garabullo/garabullo2018/imagenes wiki/step_up_regular.jpg

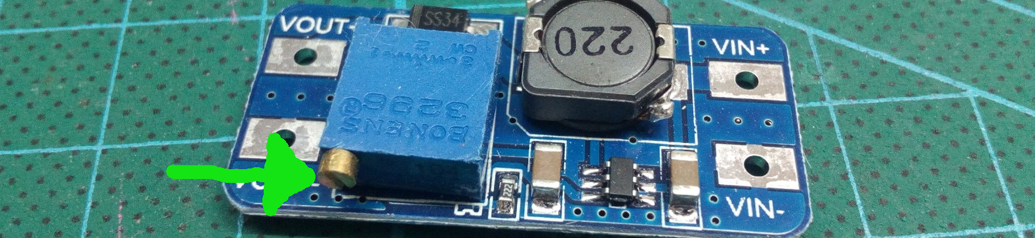
imagenes wiki/step_up_regular.jpg
