garabullo/garabullo2018/imagenes wiki/regular_step_up.jpg

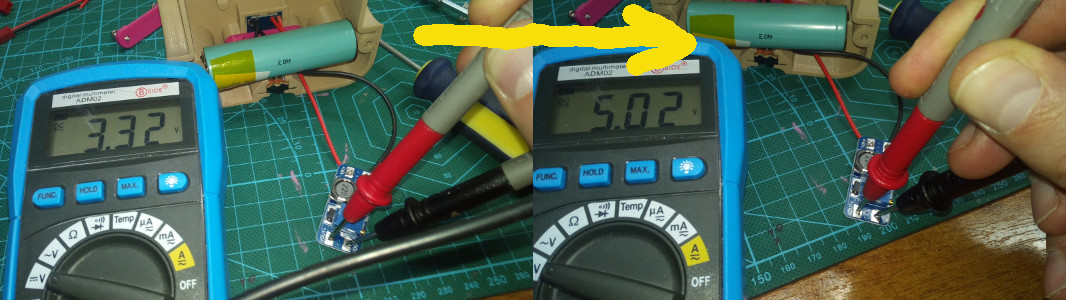
imagenes wiki/regular_step_up.jpg
