garabullo/garabullo2018/README.md

# garabullo2018
Versión 2018 del robot garabullo
Toda la información en https://github.com/garabullo/garabullo2018/wiki/1-Home
