garabullo/garabullo2018/imagenes placa/10k_2.jpg

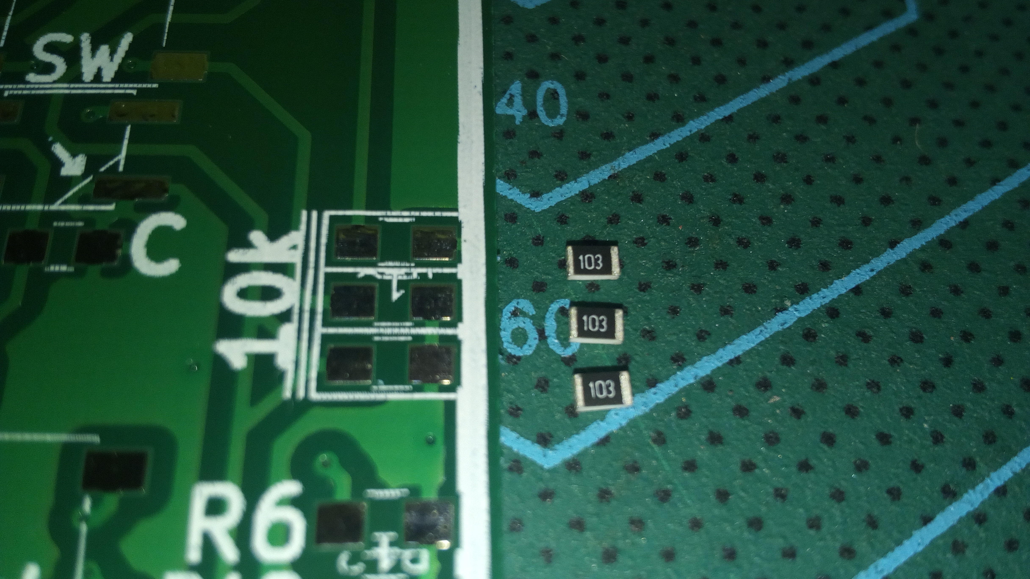
imagenes placa/10k_2.jpg
