garabullo/garabullo2018/imagenes placa/10k_5.jpg

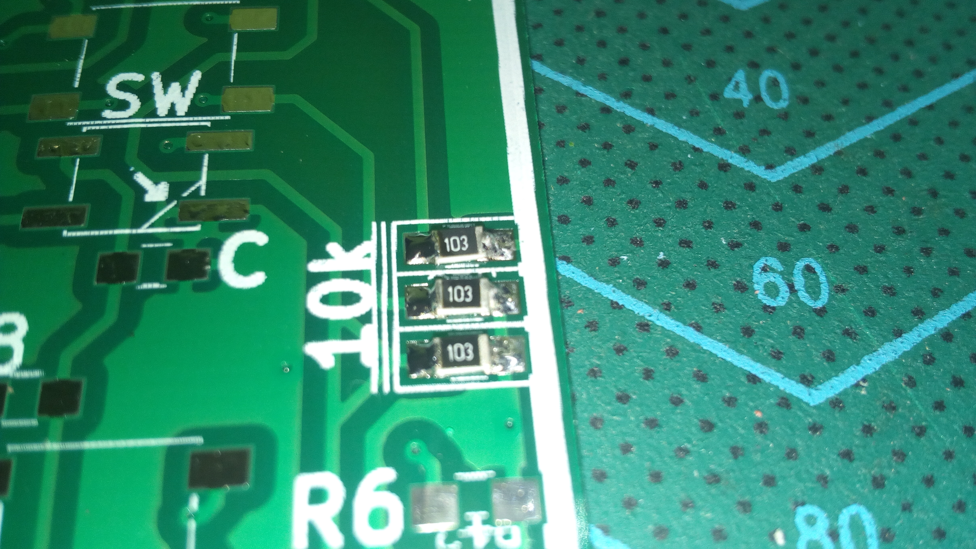
imagenes placa/10k_5.jpg
