garabullo/garabullo2018/imagenes placa/buzzer_2.jpg

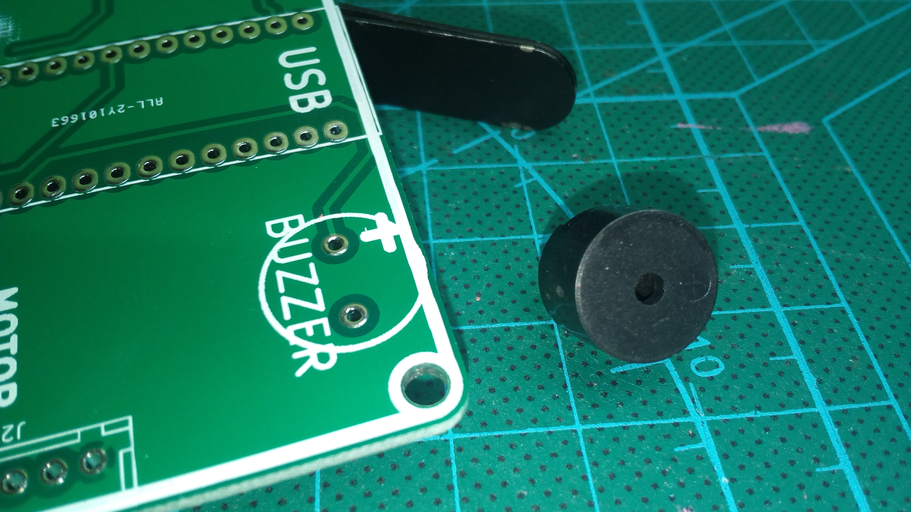
imagenes placa/buzzer_2.jpg
