garabullo/garabullo2018/imagenes placa/buzzer_3.jpg

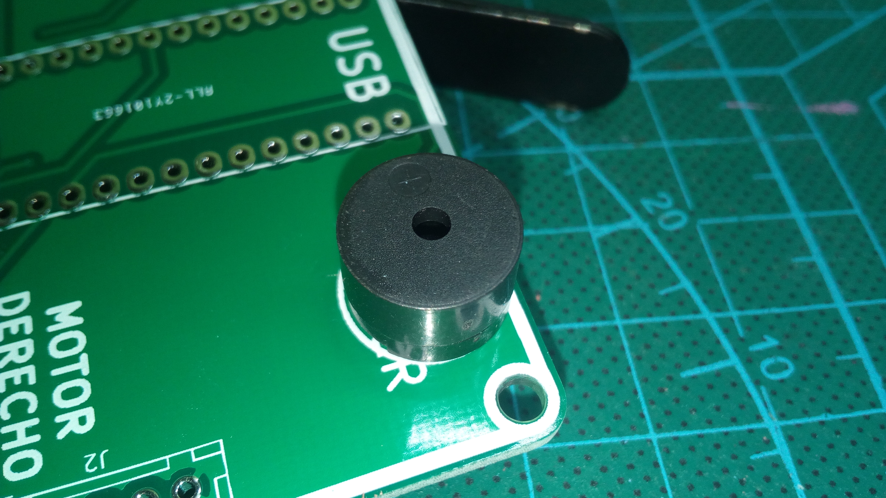
imagenes placa/buzzer_3.jpg
