garabullo/garabullo2018/imagenes placa/buzzer_ 1.jpg

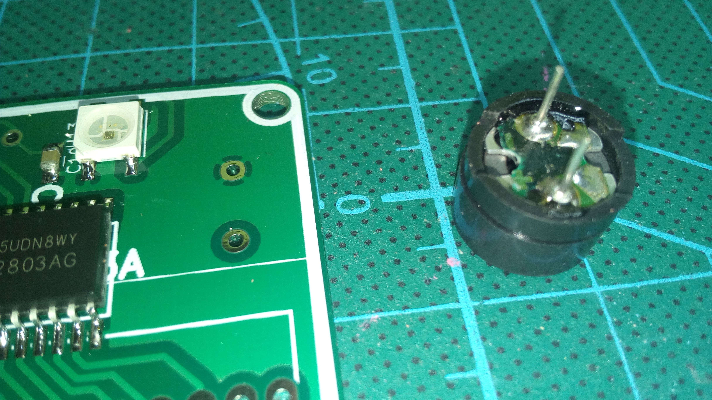
imagenes placa/buzzer_ 1.jpg
