garabullo/garabullo2018/imagenes placa/con_motor1.jpg

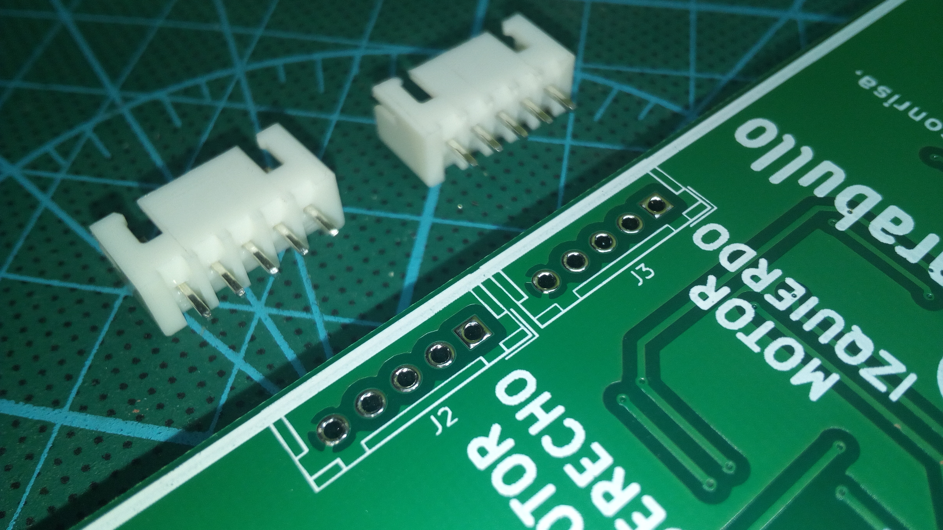
imagenes placa/con_motor1.jpg
