garabullo/garabullo2018/imagenes placa/con_motor2.jpg

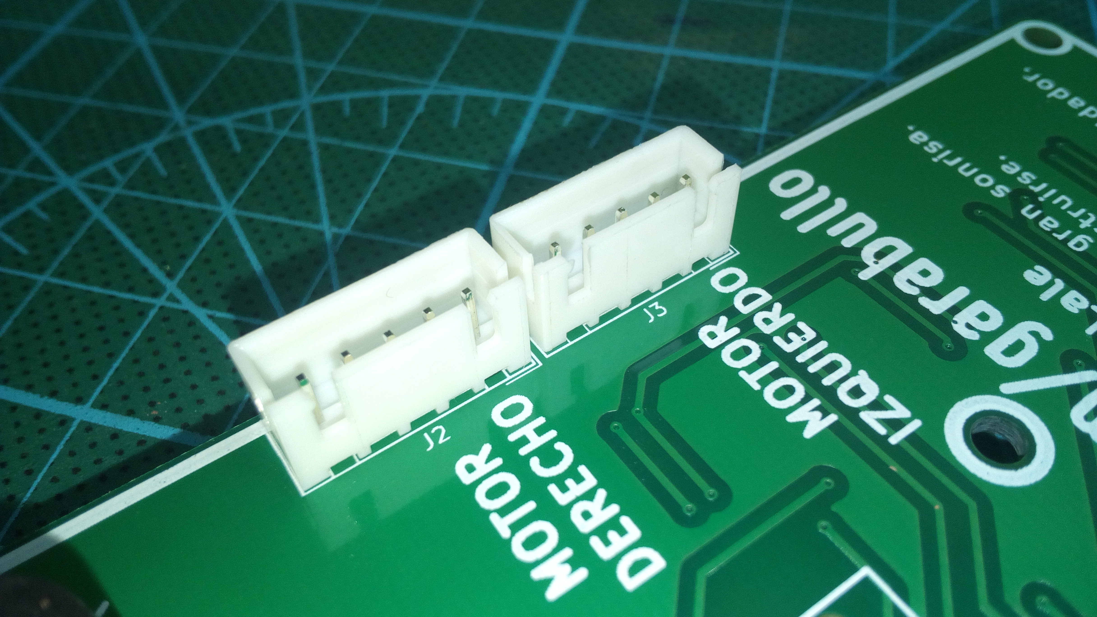
imagenes placa/con_motor2.jpg
