garabullo/garabullo2018/imagenes placa/condensador_1.jpg

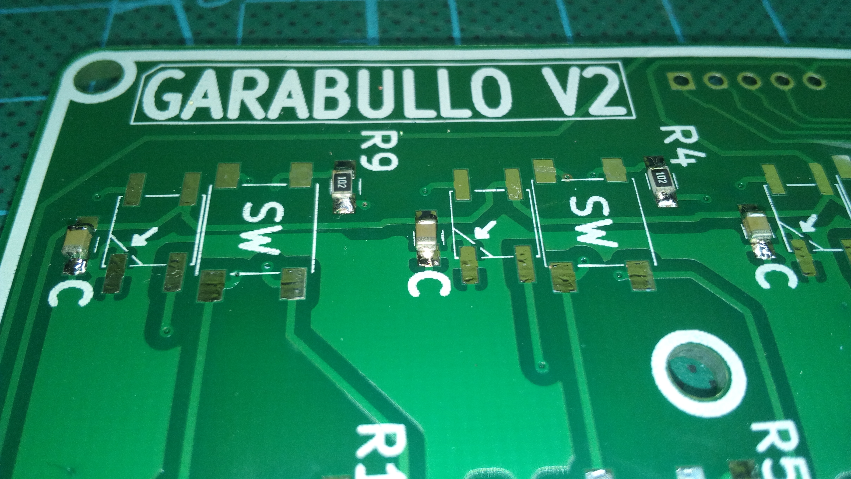
imagenes placa/condensador_1.jpg
