garabullo/garabullo2018/imagenes placa/garabullo.png

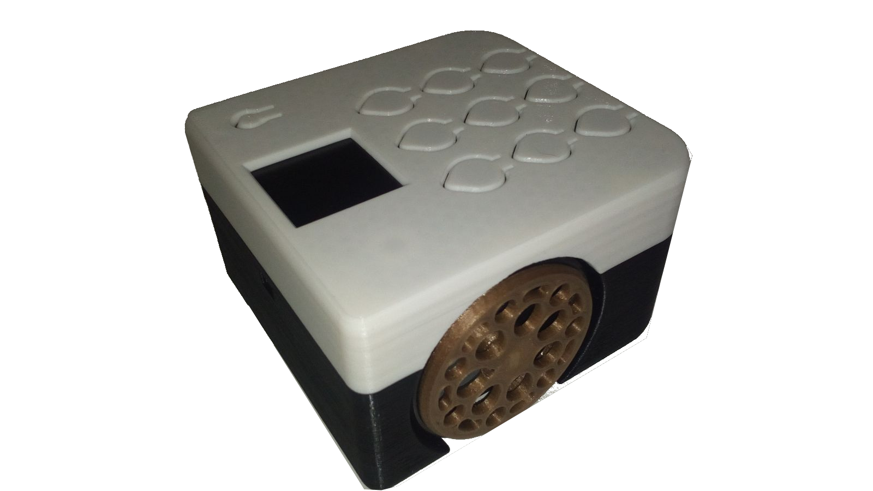
imagenes placa/garabullo.png
