garabullo/garabullo2018/imagenes placa/IMG_20180305_155818.jpg

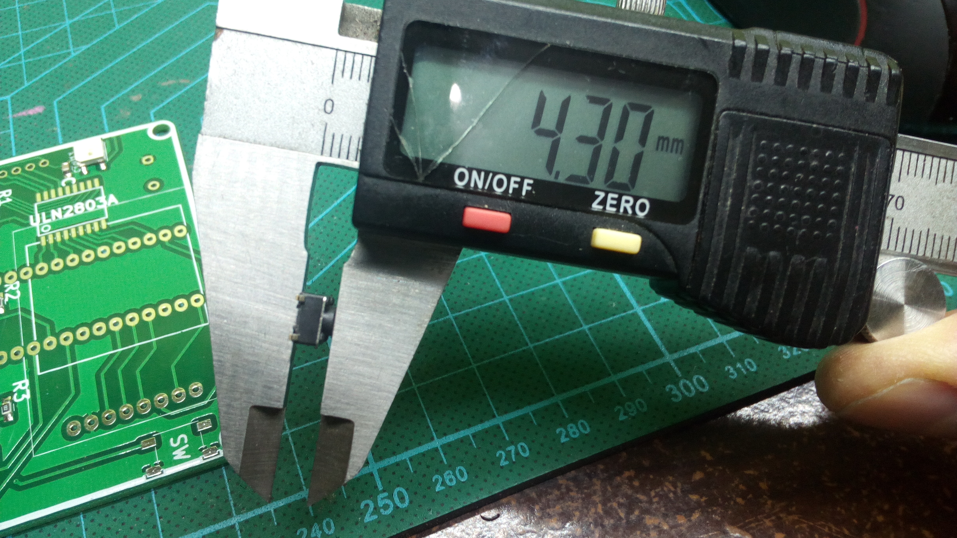
imagenes placa/IMG_20180305_155818.jpg
