garabullo/garabullo2018/imagenes placa/led_1.jpg

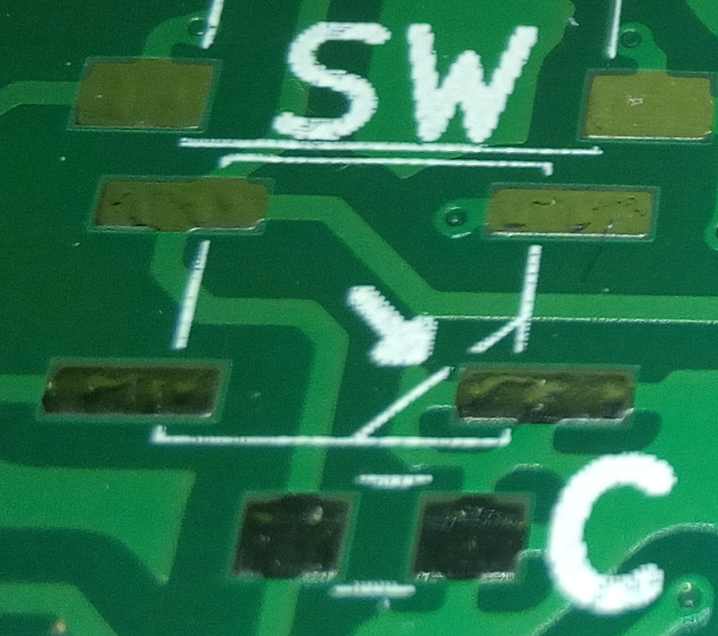
imagenes placa/led_1.jpg
