garabullo/garabullo2018/imagenes placa/led_3.jpg

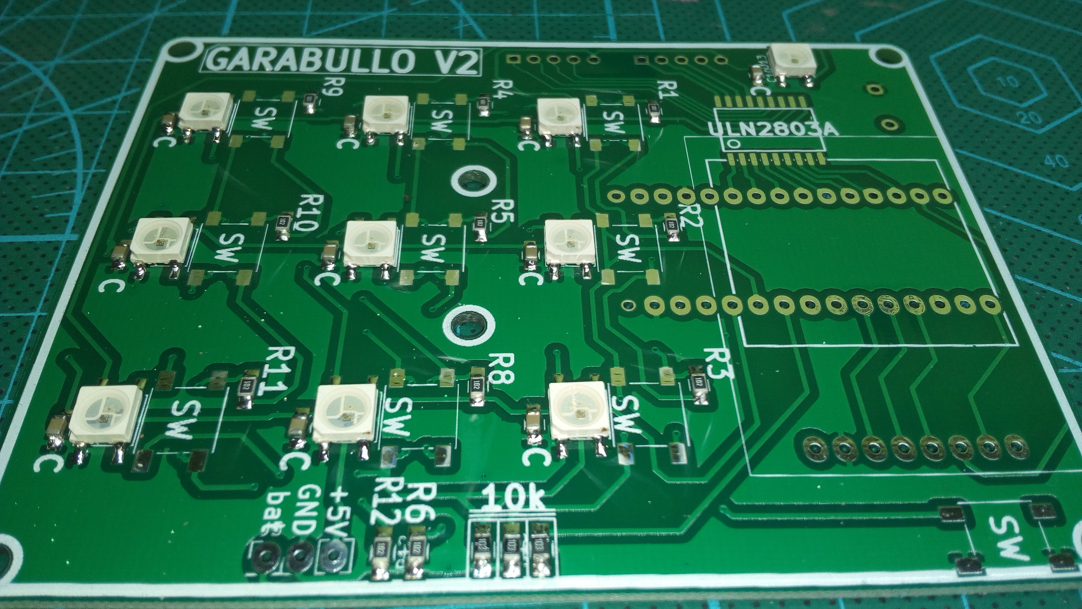
imagenes placa/led_3.jpg
