garabullo/garabullo2018/imagenes placa/magic_tiles.jpg

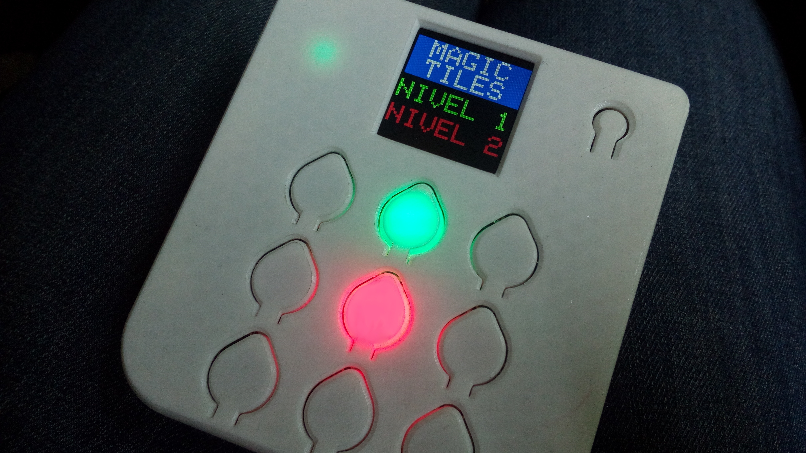
imagenes placa/magic_tiles.jpg
