garabullo/garabullo2018/imagenes placa/nivel1.jpg

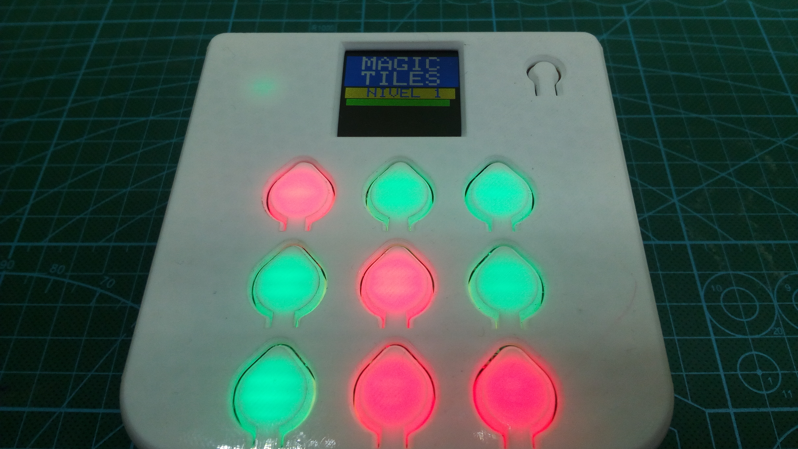
imagenes placa/nivel1.jpg
