garabullo/garabullo2018/imagenes placa/nivel2.jpg

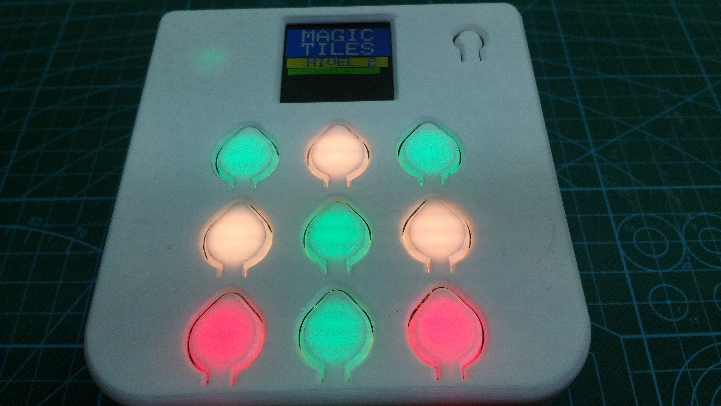
imagenes placa/nivel2.jpg
