garabullo/garabullo2018/imagenes placa/pantalla_driver.jpg

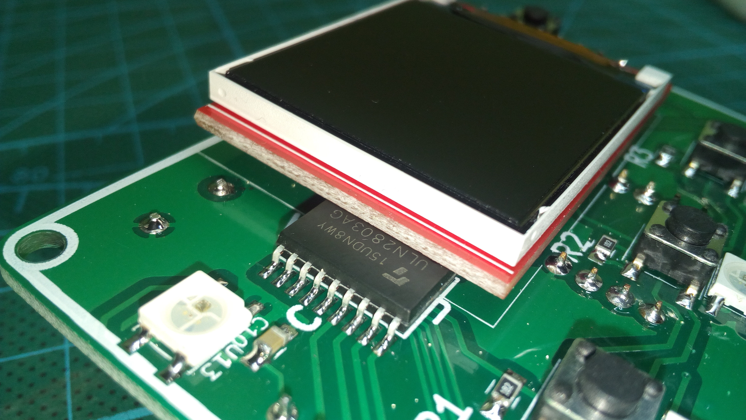
imagenes placa/pantalla_driver.jpg
