garabullo/garabullo2018/imagenes placa/pantalla_magic_tiles.jpg

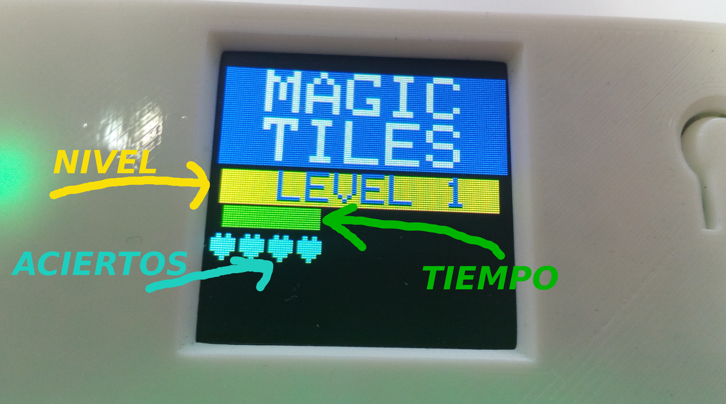
imagenes placa/pantalla_magic_tiles.jpg
