garabullo/garabullo2018/imagenes placa/pines_arduino_2.jpg

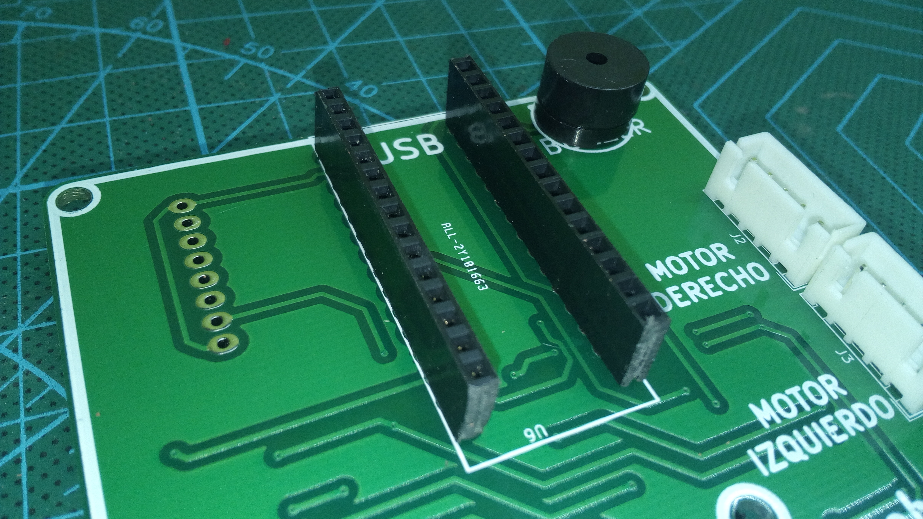
imagenes placa/pines_arduino_2.jpg
