garabullo/garabullo2018/imagenes wiki/baterias1.jpg

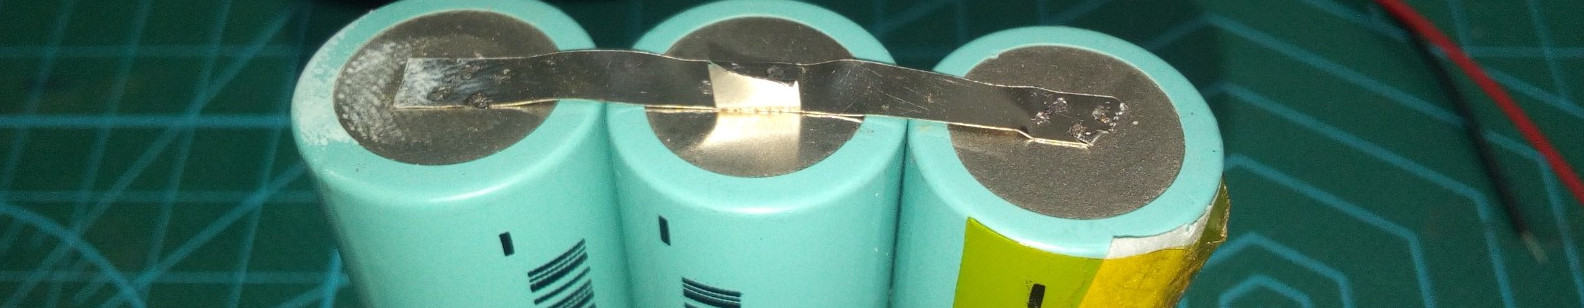
imagenes wiki/baterias1.jpg
