garabullo/garabullo2018/imagenes wiki/baterias2.jpg

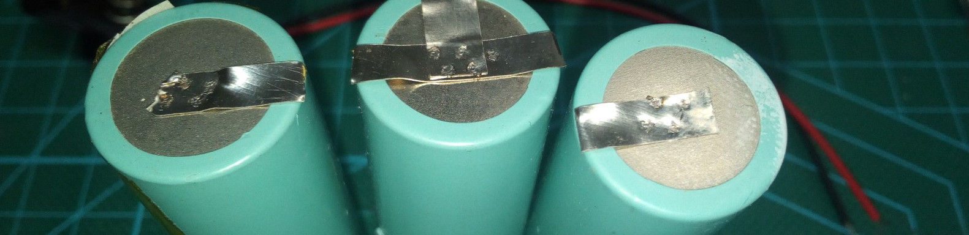
imagenes wiki/baterias2.jpg
