garabullo/garabullo2018/imagenes wiki/cable_servo.jpg

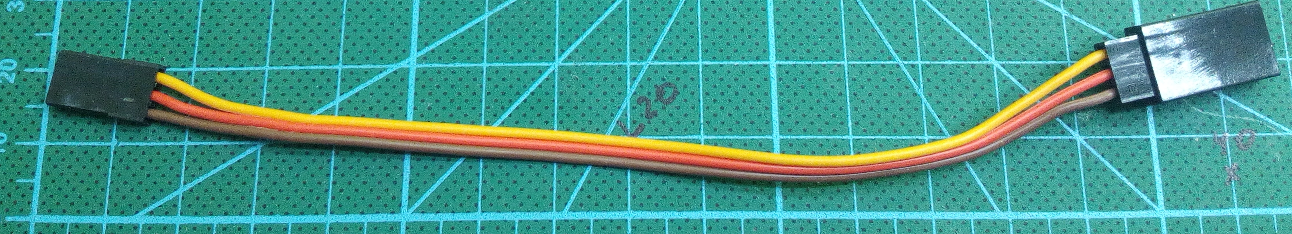
imagenes wiki/cable_servo.jpg
