garabullo/garabullo2018/imagenes wiki/cable_servo_cortado.jpg

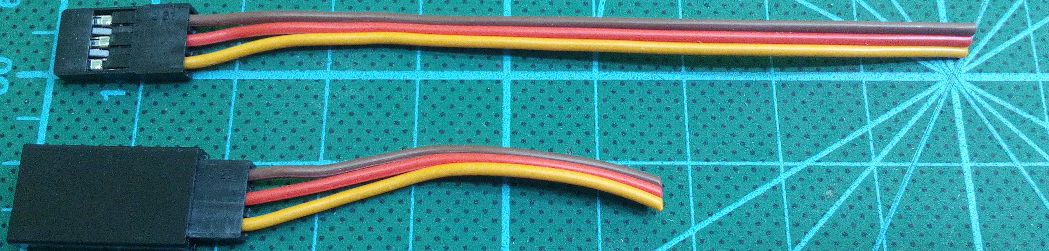
imagenes wiki/cable_servo_cortado.jpg
