garabullo/garabullo2018/imagenes wiki/cables.jpg

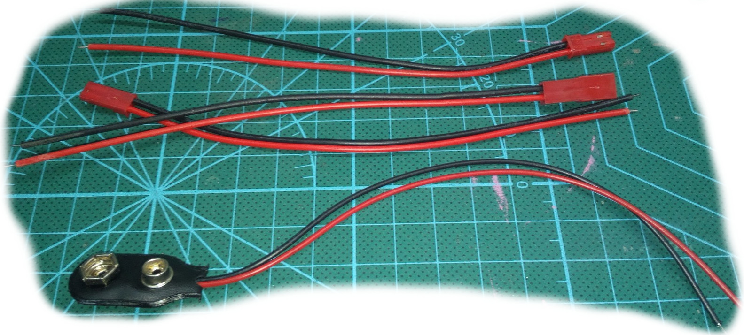
imagenes wiki/cables.jpg
