garabullo/garabullo2018/imagenes wiki/cables_varios.jpg

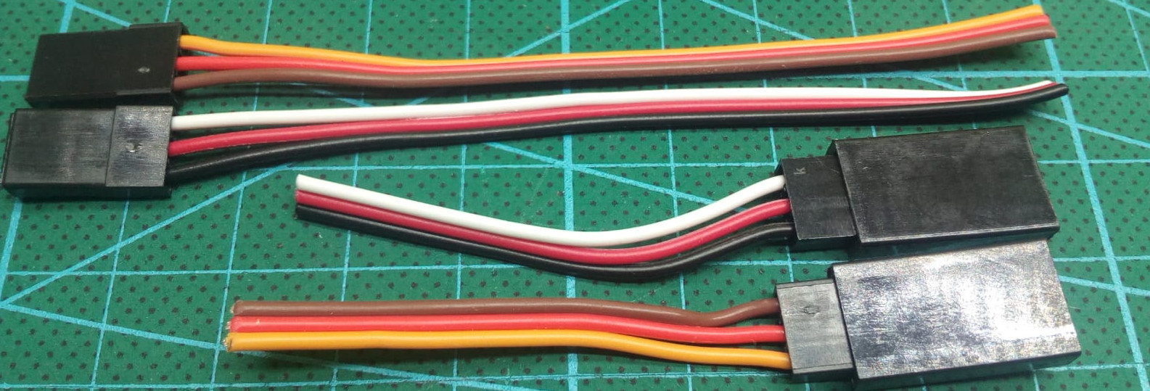
imagenes wiki/cables_varios.jpg
