garabullo/garabullo2018/imagenes wiki/cargadores.jpg

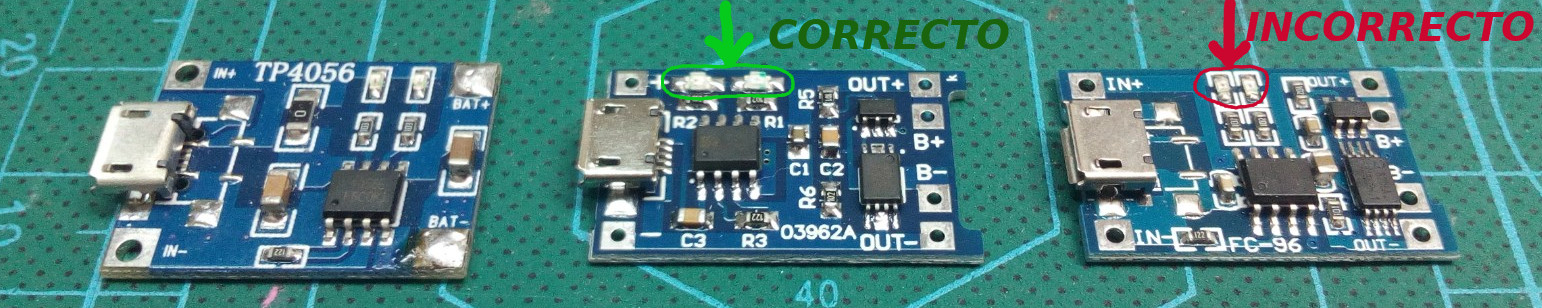
imagenes wiki/cargadores.jpg
