garabullo/garabullo2018/imagenes wiki/conexion_salida stepup.jpg

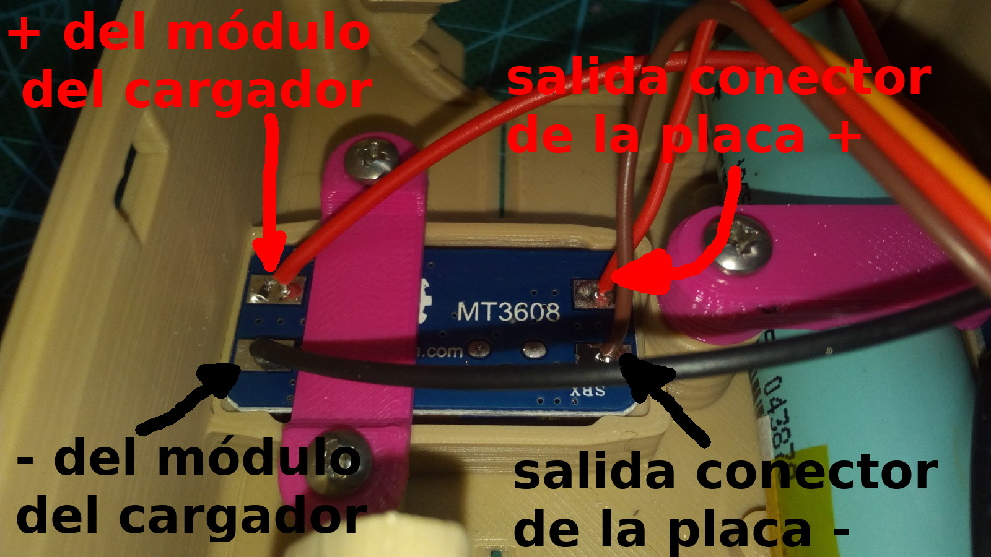
imagenes wiki/conexion_salida stepup.jpg
