garabullo/garabullo2018/imagenes wiki/garabullo.jpeg

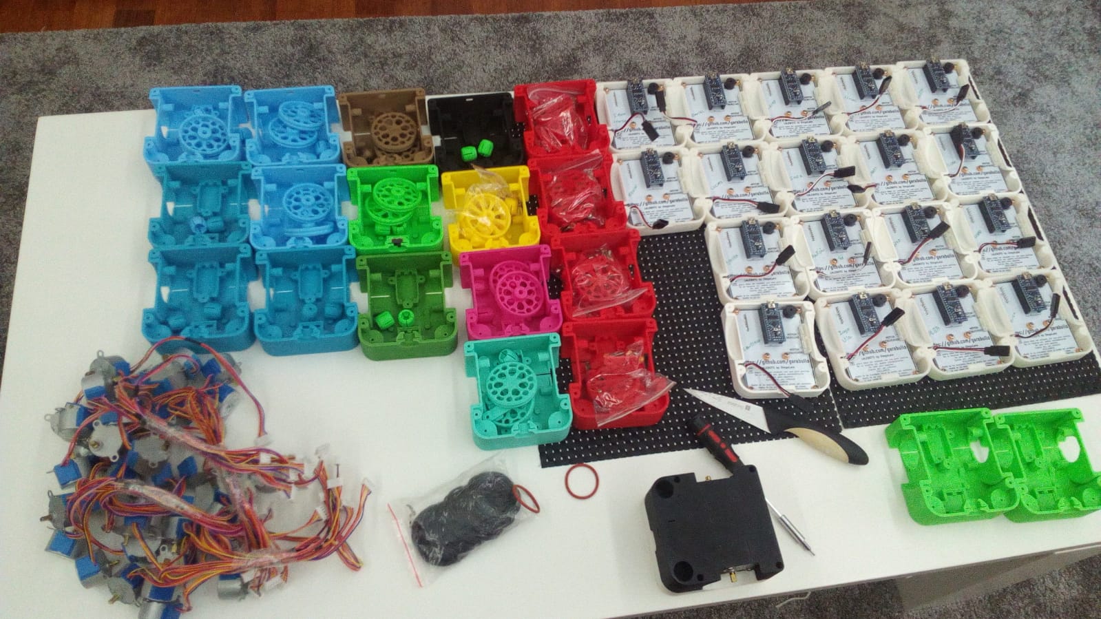
imagenes wiki/garabullo.jpeg
