garabullo/garabullo2018/imagenes wiki/interruptor_colocado.jpg

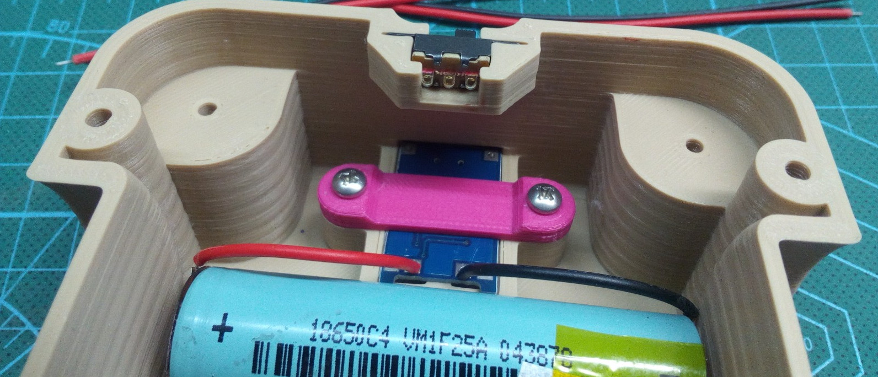
imagenes wiki/interruptor_colocado.jpg
