garabullo/garabullo2018/imagenes wiki/interruptor_soldado.jpg

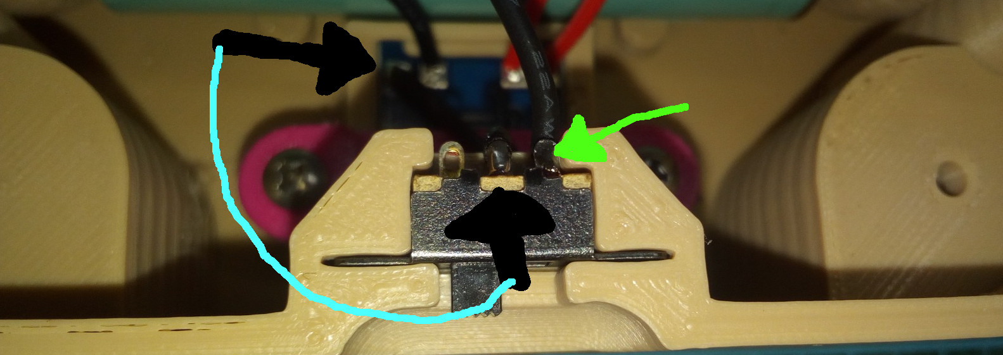
imagenes wiki/interruptor_soldado.jpg
