garabullo/garabullo2018/imagenes wiki/lamina_bateria.jpg

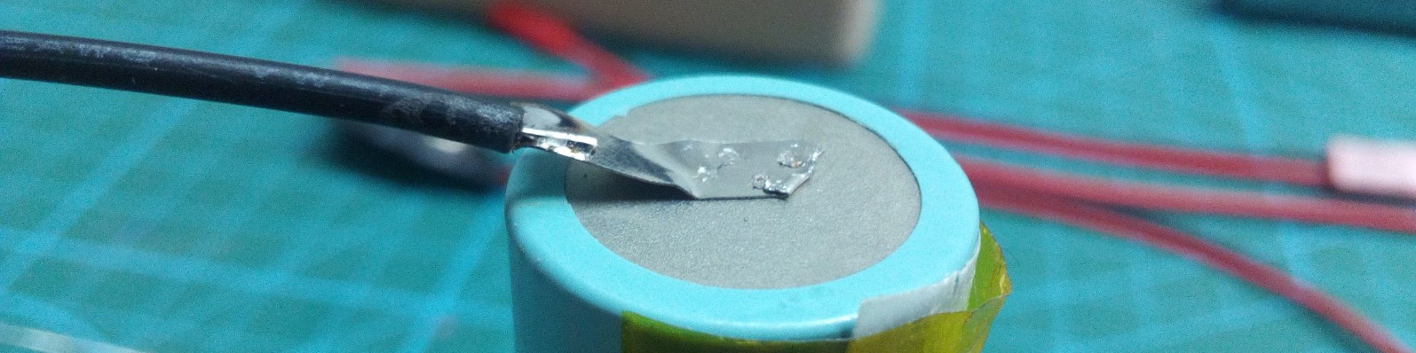
imagenes wiki/lamina_bateria.jpg
