garabullo/garabullo2018/imagenes wiki/paso1.jpg

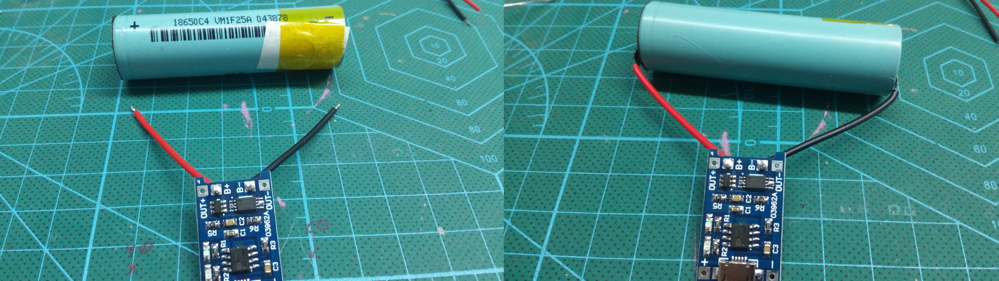
imagenes wiki/paso1.jpg
