garabullo/garabullo2018/imagenes wiki/sonda_bateria.jpg

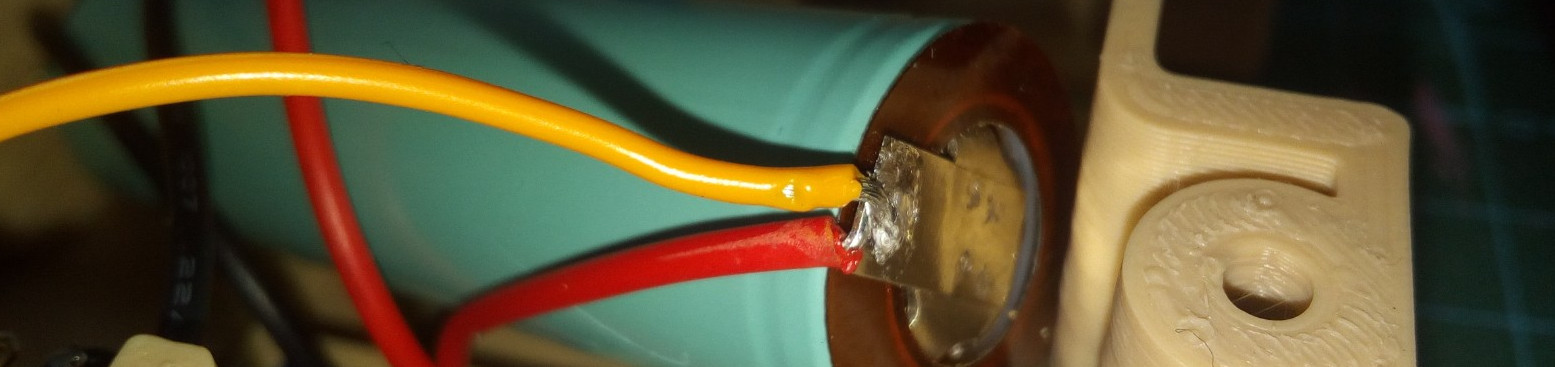
imagenes wiki/sonda_bateria.jpg
