garabullo/garabullo2018/imagenes wiki/stepup.jpg

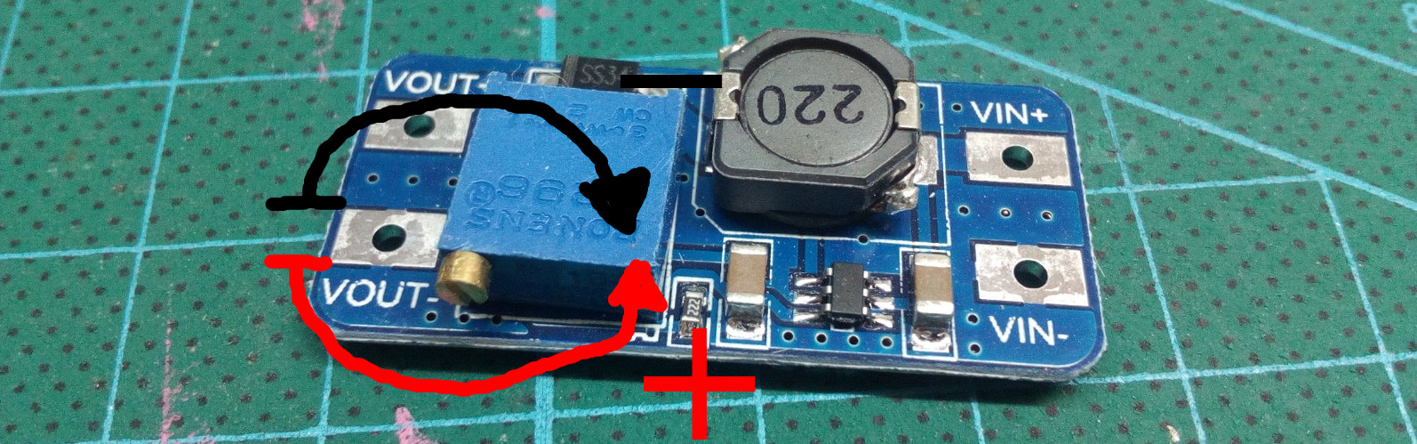
imagenes wiki/stepup.jpg
