garabullo/garabullo2018/Piezas imprimibles/src/rueda_d.fcstd

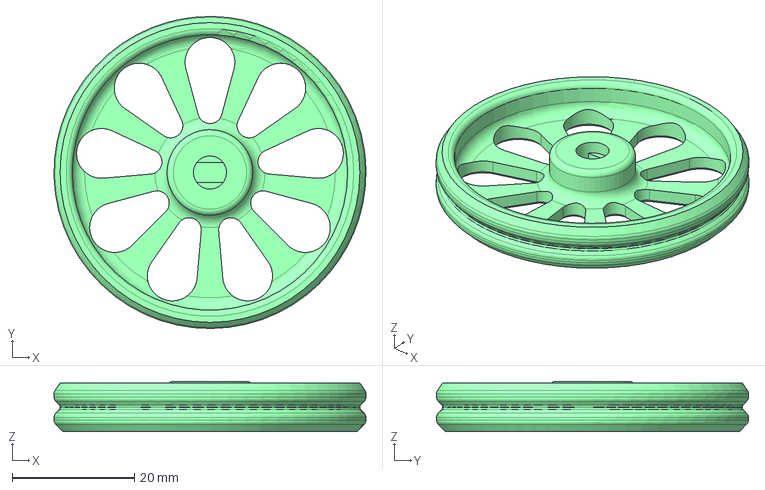
[picture p36: CAD file, 2018-03-11]
Piezas imprimibles/src/rueda_d.fcstd
51.0 x 51.0 x 8.25 mm
