garabullo/garabullo2018/Piezas imprimibles/stl/garabullo_consola.stl

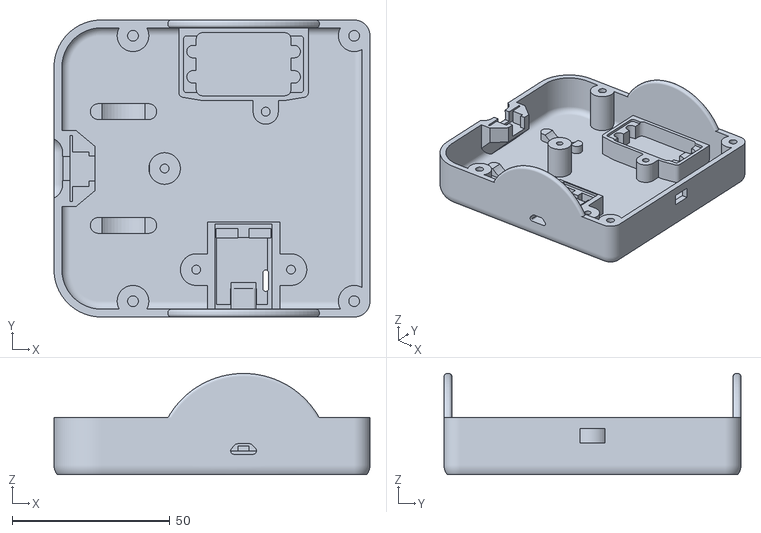
[picture p37: CAD file, 2018-10-27]
Piezas imprimibles/stl/garabullo_consola.stl
100.0 x 94.0 x 32.0
