garabullo/garabullo2018/Piezas imprimibles/src/rueda_b.fcstd

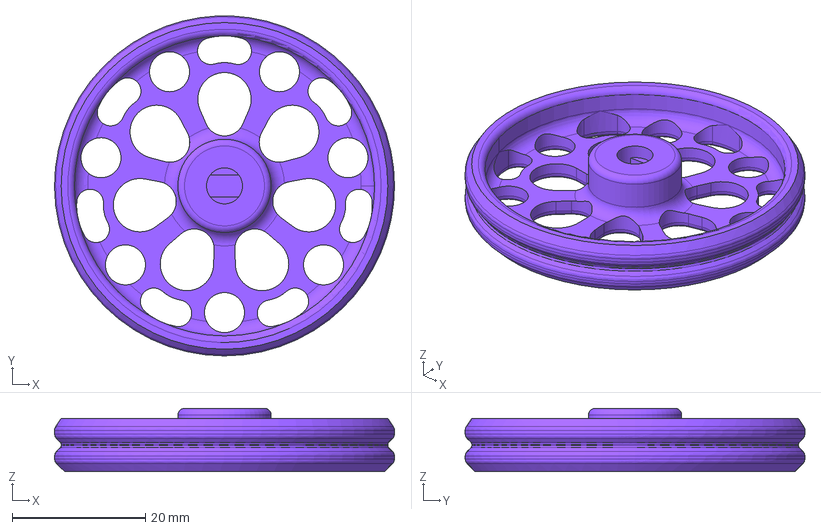
[picture p38: CAD file, 2018-03-08]
Piezas imprimibles/src/rueda_b.fcstd
51.0 x 51.0 x 9.50 mm
