garabullo/garabullo2018/Piezas imprimibles/src/cierre_cargador_y_step_up.fcstd

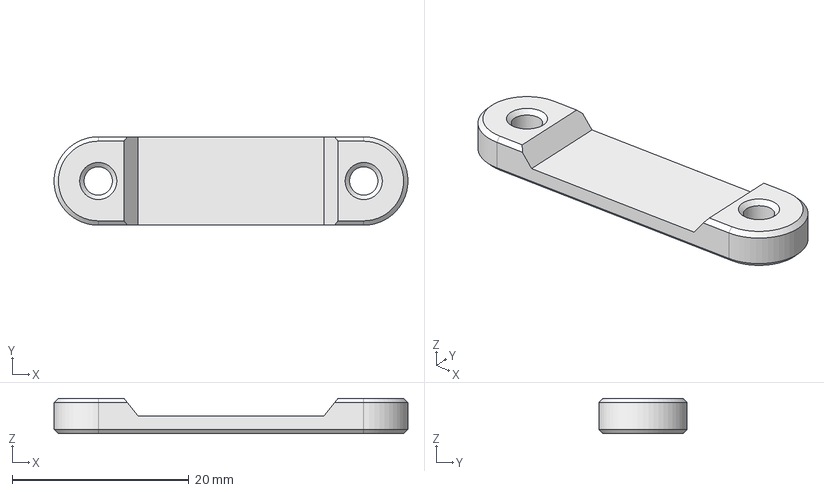
[picture p39: CAD file, 2018-03-08]
Piezas imprimibles/src/cierre_cargador_y_step_up.fcstd
40.0 x 10.0 x 4.00 mm
