garabullo/garabullo2018/Piezas imprimibles/src/rueda_a.fcstd

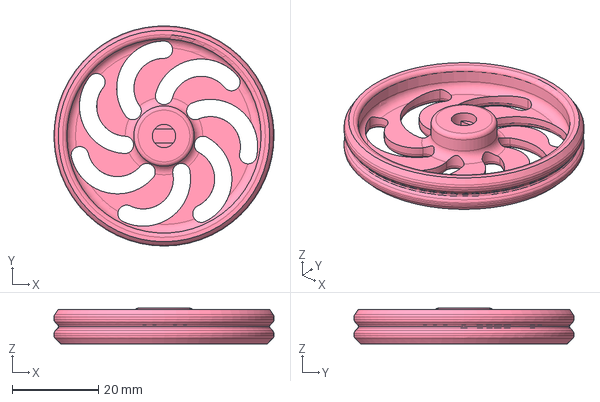
[picture p40: CAD file, 2018-03-08]
Piezas imprimibles/src/rueda_a.fcstd
51.0 x 51.0 x 8.25 mm
