garabullo/garabullo2018/Piezas imprimibles/src/bola_loca.fcstd

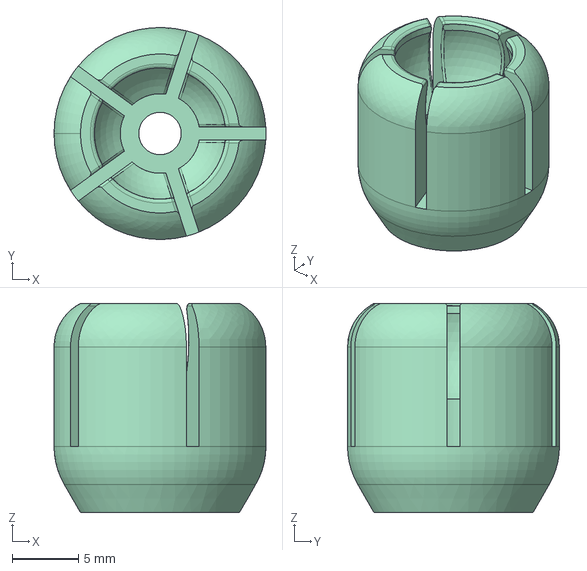
[picture p41: CAD file, 2018-03-08]
Piezas imprimibles/src/bola_loca.fcstd
16.0 x 16.0 x 15.8 mm
