garabullo/garabullo2018/Piezas imprimibles/stl/bloqueo_bateria.stl

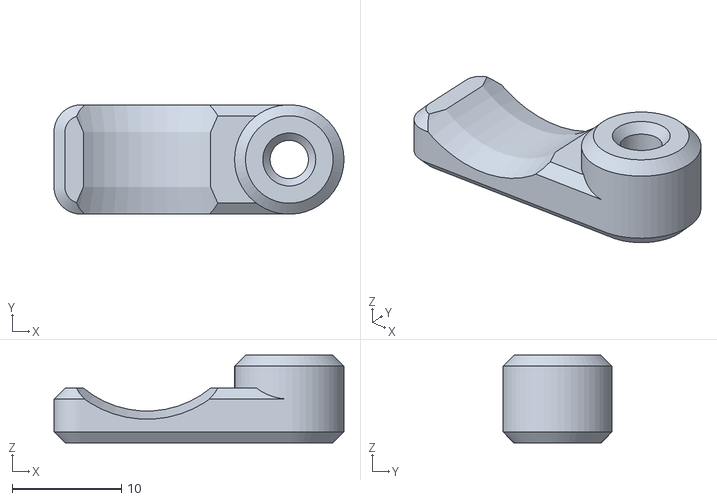
[picture p42: CAD file, 2018-03-08]
Piezas imprimibles/stl/bloqueo_bateria.stl
26.5 x 9.99 x 8.00
