garabullo/garabullo2018/Piezas imprimibles/stl/rueda_corazones.stl

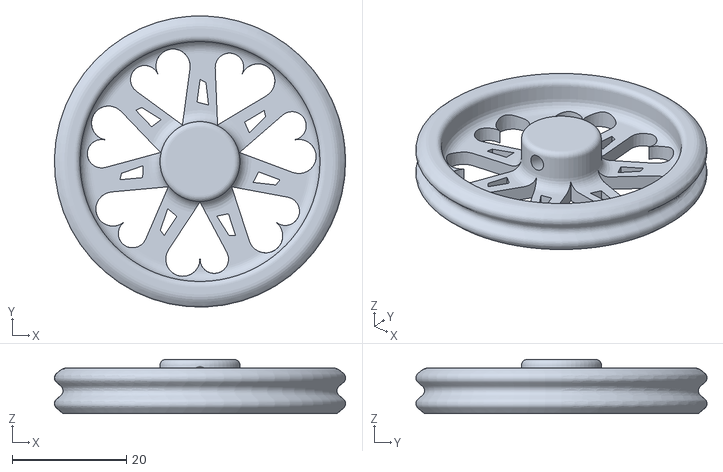
[picture p43: CAD file, 2018-01-14]
Piezas imprimibles/stl/rueda_corazones.stl
51.0 x 51.0 x 9.50
