garabullo/garabullo2018/Piezas imprimibles/stl/arandela.stl

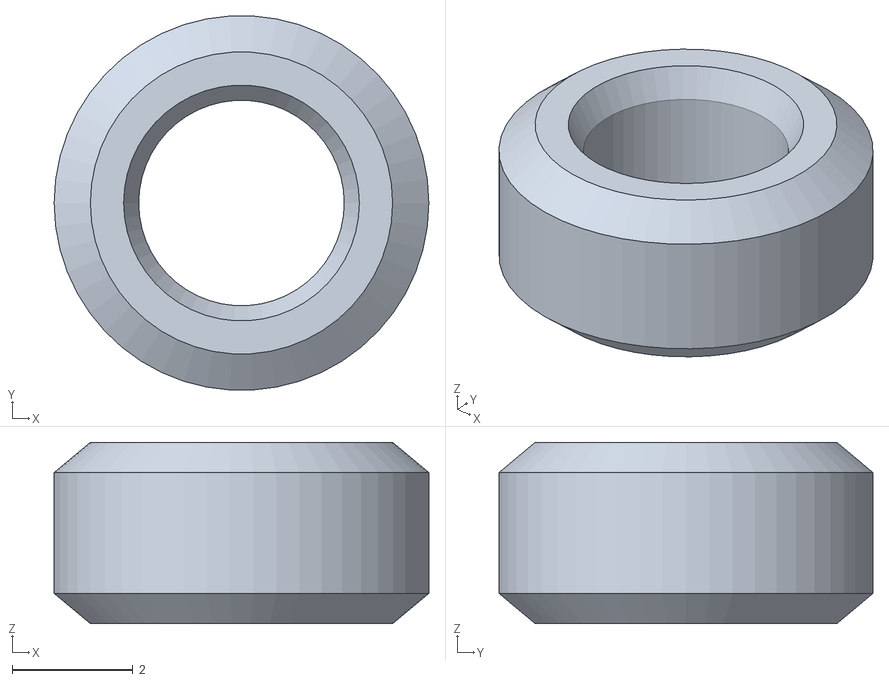
[picture p44: CAD file, 2018-01-13]
Piezas imprimibles/stl/arandela.stl
6.20 x 6.19 x 3.00
