garabullo/garabullo2018/(list of files, cad)

Other CAD files:
Piezas imprimibles/stl/rueda_d.stl
Piezas imprimibles/stl/rueda_b.stl
Piezas imprimibles/stl/rueda_a.stl
Piezas imprimibles/src/rueda_c.fcstd
Piezas imprimibles/stl/cierre_cargador_step_up.stl
Piezas imprimibles/stl/rueda_c.stl
Piezas imprimibles/stl/bola_loca.stl
Piezas imprimibles/stl/bloqueo_cargadorYstepup.stl
Piezas imprimibles/src/garabullo2tapa_reforzada.scad
Piezas imprimibles/src/garabullo_chasis.scad
Piezas imprimibles/src/tapa_twico.scad
obsoleto/bloqueo_bateria.stl
obsoleto/bloqueo_cargadorYstepup.stl
obsoleto/garabullo2tapamovida.scad
obsoleto/garabullo_tapa.scad
