garabullo/garabullo2018/imagenes wiki/entrada_step_up.jpg

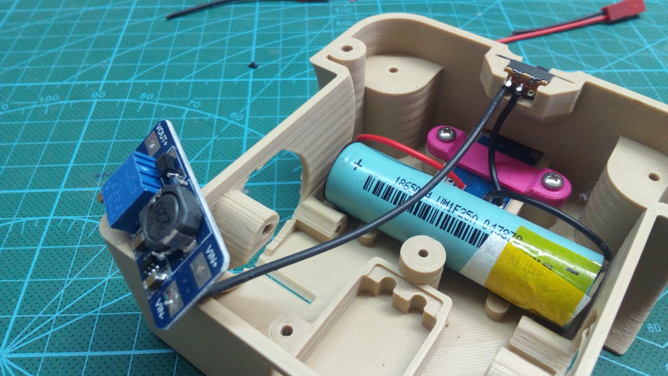
imagenes wiki/entrada_step_up.jpg
