garabullo/garabullo2018/(threads)

Thread 39 (2018-08-12):

Esquemático PCB

danybd, 2018-08-12:
He estado buscando en el repositorio un esquemático de la PCB pero no he encontrado nada. Sería posible que lo compartieses? Tengo unas dudas en cuanto a tensiones de 3,3V y 5V que solo podré resolver consultado el esquemático.
Gracias!

DiegoLale, 2018-08-13:
Hola. Tengo que subirlo, si. Estos días estoy de "vida contemplativa" en el
pueblo y no me dejaron traer el ordenador, jeje. Al acabar las vacaciones
retomaré. Lo apunto...si ves que me despisto me lo recuerdas😁

El 12 ago. 2018 4:02 p. m., "danybd" <notifications@github.com> escribió:

He estado buscando en el repositorio un esquemático de la PCB pero no he
encontrado nada. Sería posible que lo compartieses? Tengo unas dudas en
cuanto a tensiones de 3,3V y 5V que solo podré resolver consultado el
esquemático.
Gracias!

—
You are receiving this because you are subscribed to this thread.
Reply to this email directly, view it on GitHub
<https://github.com/garabullo/garabullo2018/issues/39>, or mute the thread
<https://github.com/notifications/unsubscribe-auth/AGDMLRbPuA9ipQkPwTOGFUnQD8D6DinEks5uQDVwgaJpZM4V5jQT>
.

danybd, 2020-08-24:
Hola Diego,
has podido subir el esquema de la pcb? Me gustaría hacer un Fork del proyecto incluyendo algunos cambios. Saludos y gracias!

DiegoLale, 2020-08-27:
Soy un desastre. Te mando mi móvil y gestionamos por WhatsApp si quieres.
661932737
Presióname!!!😅
Si eso te meto en la "organización" de garabullo con "plenos derechos" y
haces en él según tu voluntad😎

El lun., 24 ago. 2020 18:13, danybd <notifications@github.com> escribió:

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

Thread 41 (2018-10-17):

5V GND y BAT

danybd, 2018-10-17:
Hola,
una duda que tengo con respecto a los paths +5V GND y bat. Cual es su funcion? Se tiene que soldar algun 7805? O simplemente una bateria y usar el regulador lineal del arduino?

Saludos!

DiegoLale, 2018-10-18:
Hola. La salida del step-up de + va a 5v y la - a gnd. (Despues de regular
el step up). A mayores saca un cable del positivo de la batería a bat. Está
conectado a una entrada analógica para monitorizar el nivel de carga de
batería.
Saludos

El mié., 17 oct. 2018 20:34, danybd <notifications@github.com> escribió:

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

danybd, 2018-10-18:
Hola Diego. Y cual es la tension maxima que puede tener la batería? Porque entiendo que la monitorización se hace directamente sobre un canal ADC del arduino. Esta pensado para una LIPO? Dos pilas AA?
Saludos

DiegoLale, 2018-10-18:
Una lipo, como máximo 4.2 aprox.
Está aquí el sistema:
https://github.com/garabullo/garabullo2018/wiki/2--Alimentación

El jue., 18 oct. 2018 18:56, danybd <notifications@github.com> escribió:

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

danybd, 2018-10-18:
Gracias!!!

Closed 2018-10-18.

Thread 45 (2019-03-12):

Junta torica ruedas

danybd, 2019-03-12:
Hola,
quería preguntarte cual es la medida de las juntas tóricas que llevan las ruedas, pues he comprado unas de 63-65mm y le quedan enormes. Cuales le has montado tú?

Gracias

DiegoLale, 2019-03-13:
Hola, hay varias medidas que pueden valer. de unos 38-40mm son las que uso yo. De 2mm o 2.5mm de diámetro. Un saludo.

Closed 2019-10-27.

Thread 46 (2019-09-29):

Cargar firmware

Fendetestas72, 2019-09-29:
Buenas, pues como dice el título, soy incapaz de cargar el firmware. Me pone que es demasiado grande para el Arduino Nano.
Necesito ayudaaaaaaaaa!!!!!!!!
Gracias.

DiegoLale, 2019-10-23:
Perdón, he estado muy ausente, el problema es que con las últimas versiones de las librerías, éstas ocupan más espacio, este fin de semana cuelgo un firmware aligerado para evitar ese problema, y perdón por la demora.

Fendetestas72, 2019-10-25:
Ok Diego, muchas gracias.

El mié., 23 oct. 2019 a las 22:20, DiegoLale (<notifications@github.com>)
escribió:

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

DiegoLale, 2019-10-27:
Listo, acabo de subir la versión "GARABULLO18_1.0".
Con arduino 1.8.10 y las librerías actualizadas a día de hoy ya funciona.
Ya me cuentas si sirve

Fendetestas72, 2019-10-29:
Pues parece que no va, o por lo menos a mi, me sale esto
El Sketch usa 30828 bytes (100%) del espacio de almacenamiento de programa. El máximo es 30720 bytes.
Las variables Globales usan 921 bytes (44%) de la memoria dinámica, dejando 1127 bytes para las variables locales. El máximo es 2048 bytes.

DiegoLale, 2019-10-29:
Dime que sistema operativo, versión de arduino y versión de las librerías tienes:
Adafruit_GFX.h
Adafruit_ST7735.h
Adafruit_NeoPixel.h

Fendetestas72, 2019-11-03:
Todo correcto, tenía las librerías sin actualizar, ahora va perfecto, gracias y perdona por dar la brasa, si vas por la OSHWDEM, te invito a una birra.

DiegoLale, 2019-11-03:
Perfecto, mejor así. Este año no toca, nos vemos en la siguiente.

Closed 2019-11-03.
