garabullo/garabullo2018/Diagrama de conexionado eléctrico entre partes.pdf

## DIAGRAMA DE CONEXIONADO ELÉCTRICO ENTRE PARTES

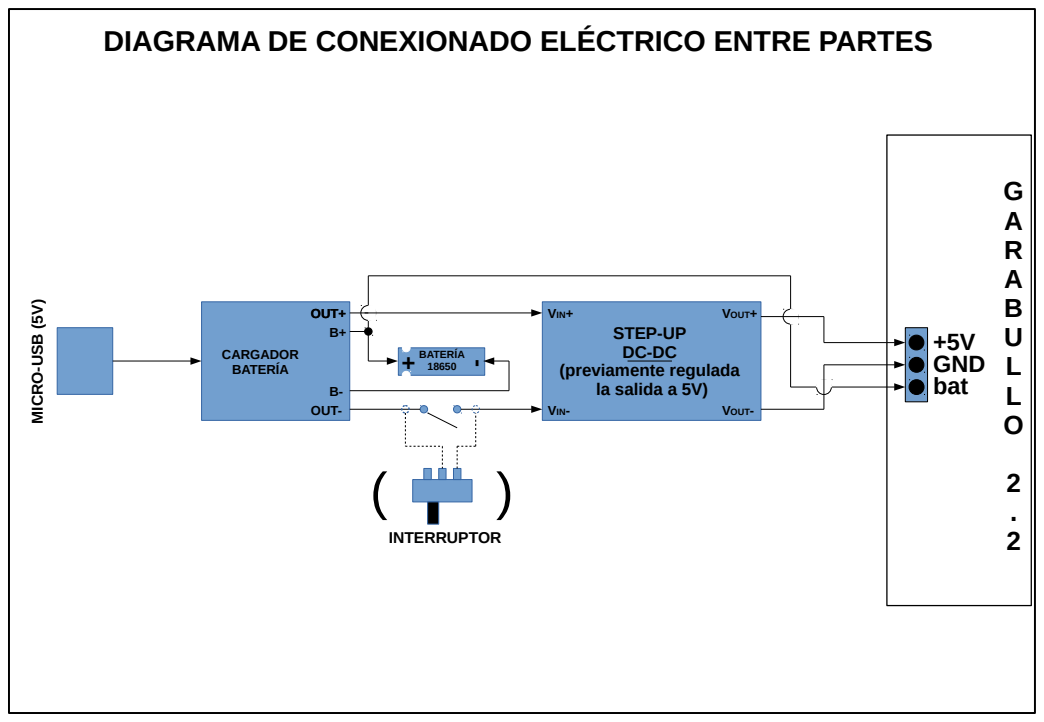
[picture p46: page 1]
STEP-UP DC-DC (previamente regulada la salida a 5V); MIC; CARGADOR BATERÍA; OUT+; OUT-; BATERÍA 18650; INTERRUPTOR; VIN-; VIN+; VOUT+; VOUT-; +5V GND bat
