garabullo/garabullo2018/arduino/BASICOS/GARABULLO18_matematicas/configuracion.h

String propietario = "*nombre*"; // ¡Anda majete!, pon aquí tu nombre (máximo 10 letras)
String version_firmware = "math 1.0";

//umbral lecturas 
#define umbral  30

//lecturas tipo de cada boton
//empieza a contar desde cero para coincidir con los leds
// y así hacer más fácil la programación led-pulsador-onda-corpúsculo ;)
int lectura_boton_0 = 786;
int lectura_boton_1 = 601; 
int lectura_boton_2 = 443; 
int lectura_boton_3 = 299; 
int lectura_boton_4 = 156; 

int lectura_boton_5 = 759; 
int lectura_boton_6 = 549; 
int lectura_boton_7 = 364; 
int lectura_boton_8 = 188; 


// esta variable almacena el brillo inicial. Es modificable mediante el menu de configuración
byte brillo = 25;

int tiempoEntrePaso = 1350;
/****************************Variables pasosRecto y pasosGiro**************************************
   En pasosRecto se debe almacenar el número de pasos que necesita GARABULLO para avanzar un cuadro
   En pasosGiro se debe almacenar el número de pasos que necesita GARABULLO para girar 90º
*/
byte pasos_recto;
byte pasos_giro;
