garabullo/garabullo2018/arduino/BASICOS/GARABULLO18_matematicas/tiempo.ino

boolean test_tiempo_suficiente()
{
  tiempo_actual = millis();
  medida_tiempo = (tiempo_actual - tiempo_inicio) / 1000; //esta variable se usa para la longitud de la barra de tiempo
  if (tiempo_actual - tiempo_inicio > 120000)
  {
    return 0;
  }
  else return 1;
}


void muestra_barra_crono()
{
  pantalla.fillRect(4, 72, 120 - medida_tiempo, 10, ST7735_GREEN);
  pantalla.fillRect(124 - medida_tiempo, 72, medida_tiempo , 10, ST7735_BLACK);
}


void barra_nueva(long tiempo_pasado_como_parametro, int posicion_altura, long tiempo_de_juego)
{
  tiempo_pasado_como_parametro = map(tiempo_pasado_como_parametro, 0, tiempo_de_juego, 0,120);
  pantalla.fillRect(4, posicion_altura, 120 - tiempo_pasado_como_parametro, 4, ST7735_GREEN);
  pantalla.fillRect(124 - tiempo_pasado_como_parametro, posicion_altura, tiempo_pasado_como_parametro , 4, ST7735_BLACK);
}
