garabullo/garabullo2018/(commit log)

2018-01-13 :bowtie: piezas imprimibles :bowtie:
    [arandela.stl, bloqueo_bateria.stl, bloqueo_cargadorYstepup.stl]
2018-01-13 :bike: rueda :bike:
    [rueda_corazones.stl]
2018-01-13 :bike: rueda corregida :bike:
    [rueda_corazones.stl]
2018-01-14 prueba de pantalla
    [rueda_corazones.stl]
2018-01-14 programa prueba leds
2018-02-03 :bowtie: programas para alfatesters :bowtie:
2018-03-07 imágenes para wiki
2018-03-08 :cyclone:piezas imprimibles y sus fuentes :cyclone:
    [bloqueo_bateria.scad, bloqueo_bateria.stl, bola_loca.fcstd, bola_loca.stl, cierre_cargador_step_up.stl, cierre_cargador_y_step_up.fcstd, garabullo_chasis.scad, garabullo_tapa.scad]
2018-03-11 :o: otra ruedita :o:
    [rueda_d.fcstd, rueda_d.stl]
2018-03-12 :bowtie: imágenes para wiki :bowtie:
2018-03-14 imagenes para wiki
2018-03-28 mas imagenes para wiki
2018-04-17 pruebas de placas
    [garabullo2tapa_reforzada.scad]
2018-05-08 reorganizando carpeta arduino
2018-10-27 :video_game: subida la pieza para hacer consola :video_game:
    [garabullo2.1_CONSOLA.scad, garabullo2tapa_reforzada.scad, garabullo_consola.stl]
2018-11-25 programa de prueba de leds
2019-02-03 arreglado magic tiles sin sonido
    [GARABULLO18_0.92.ino, bateria.ino, botonera.ino, configuracion.h, configuracion_avanzado.h, cuadros.ino, juego_baldosas.ino, juego_producto.ino]
2019-10-27 firmware simplificado
    [arandela.stl, bloqueo_bateria.scad, bloqueo_bateria.stl, bloqueo_cargadorYstepup.stl, bola_loca.fcstd, bola_loca.stl, cierre_cargador_step_up.stl, cierre_cargador_y_step_up.fcstd]
